madcatse/ZXSpectrumPlus3_Midi_output/zx_midi_case_PLA/output/fit_check/README.md

Необязательные примерочные срезы корпуса, не полноценные половинки.
Печатать по 1 шт. fit_bottom.stl и fit_top.stl в сохранённой ориентации, PLA,
слой 0,16–0,20 мм, сопло 0,4 мм. При необходимости добавить кайму 3 мм.
Крепёж: 2 винта M2 × 20 и 2 гайки M2, как у полного корпуса.
Проверяют отверстия платы, карманы гаек и стойки рядом с компонентами.
Окна разъёмов и опоры на концах платы в эти короткие образцы не входят.
