madcatse/ZXSpectrumPlus3_Midi_output/zx_midi_case_PLA/output/preview_board_in_base.png

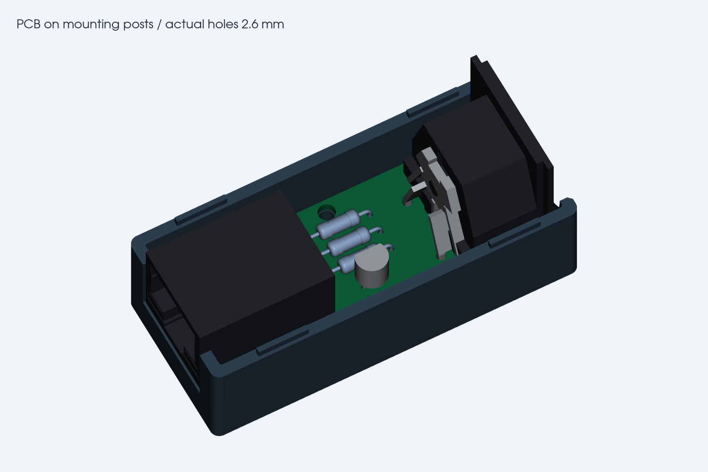
zx_midi_case_PLA/output/preview_board_in_base.png
