madcatse/ZXSpectrumPlus3_Midi_output/zx_midi_case_PLA/output/preview_exploded.png

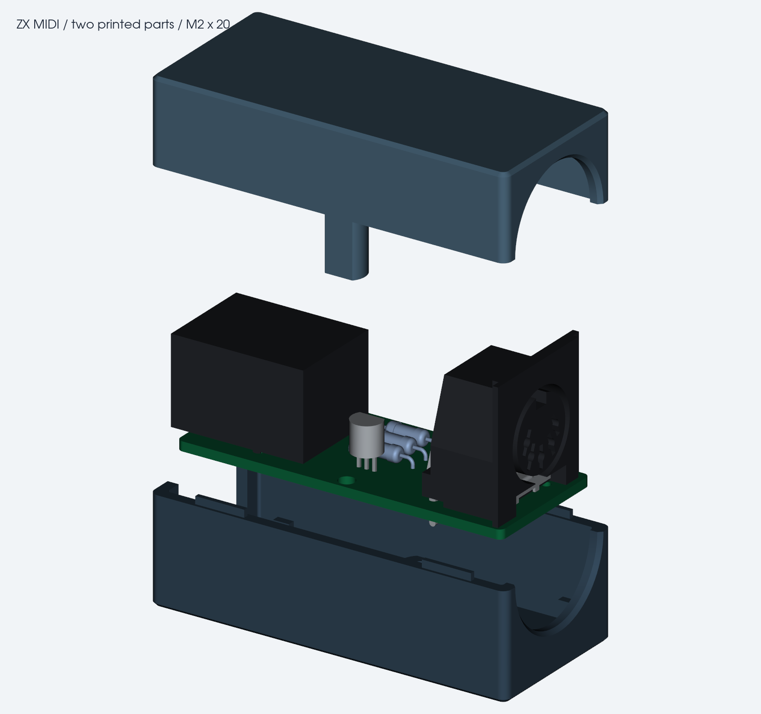
zx_midi_case_PLA/output/preview_exploded.png
