madcatse/ZXSpectrumPlus3_Midi_output/zx_midi_case_PLA/output/preview_rj45.png

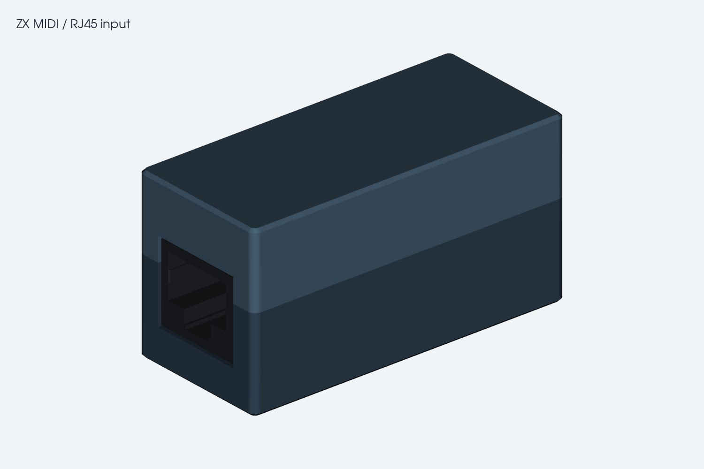
zx_midi_case_PLA/output/preview_rj45.png
