madcatse/ZXSpectrumPlus3_Midi_output/zx_midi_case_PLA/output/preview_top_inside.png

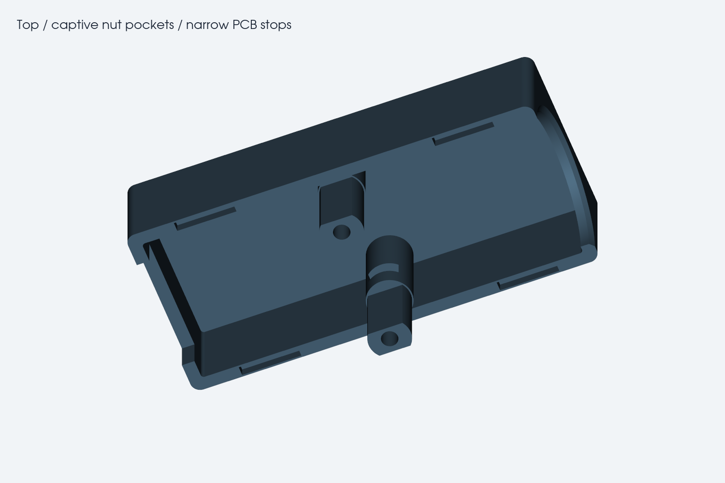
zx_midi_case_PLA/output/preview_top_inside.png
