madcatse/ZXSpectrumPlus3_Midi_output/zx_midi_case_PLA/output/assembly_with_board.step

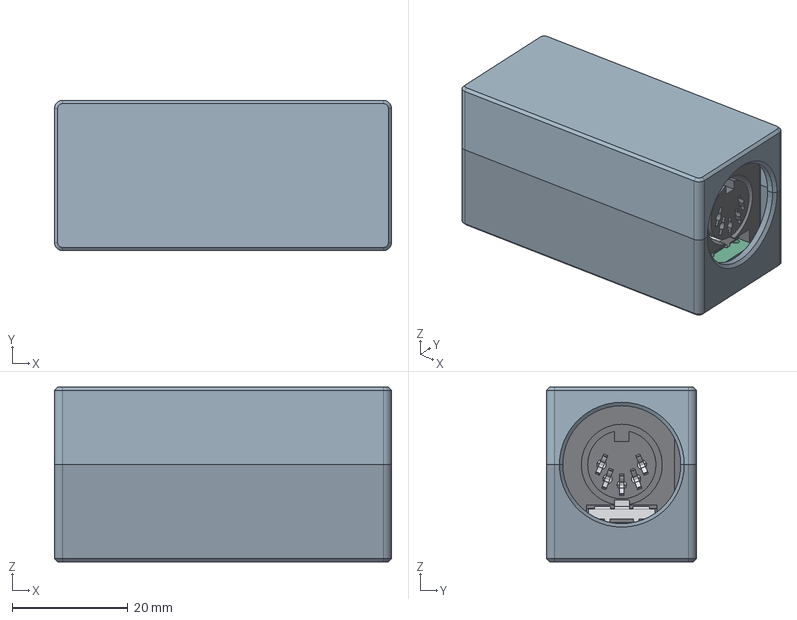
[picture p6: CAD file, 2026-10-11]
zx_midi_case_PLA/output/assembly_with_board.step
58.3 x 26.0 x 30.2 mm
Bottom
Top
PCB_reference_00
PCB_reference_01
PCB_reference_02
PCB_reference_03
PCB_reference_04
PCB_reference_05
PCB_reference_06
PCB_reference_07
PCB_reference_08
PCB_reference_09
PCB_reference_10
PCB_reference_11
PCB_reference_12
PCB_reference_13
PCB_reference_14
PCB_reference_15
PCB_reference_16
PCB_reference_17
PCB_reference_18
PCB_reference_19
PCB_reference_20
PCB_reference_21
Hardware_envelope_0
Hardware_envelope_1
Hardware_envelope_2
Hardware_envelope_3
