madcatse/ZXSpectrumPlus3_Midi_output/zx_midi_case_PLA/output/case_bottom.step

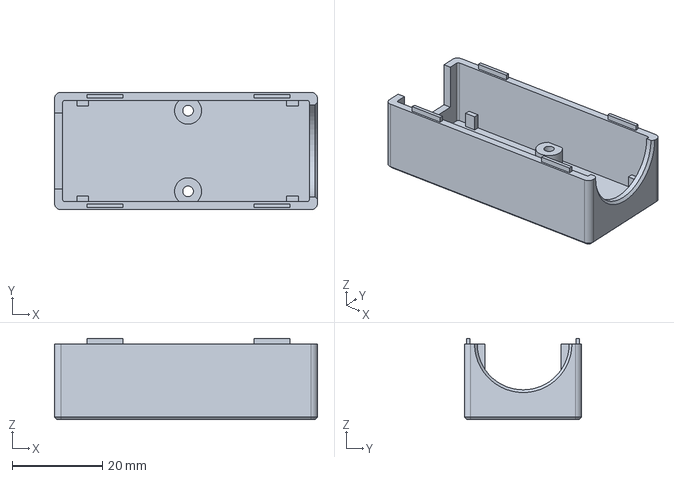
[picture p7: CAD file, 2026-10-11]
zx_midi_case_PLA/output/case_bottom.step
58.3 x 26.0 x 18.0 mm
