madcatse/ZXSpectrumPlus3_Midi_output/zx_midi_case_PLA/output/fit_check/fit_bottom.stl

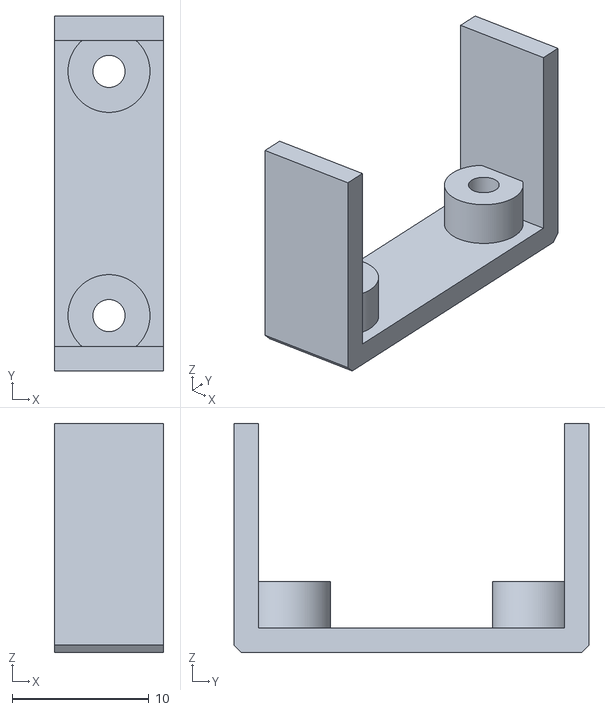
[picture p8: CAD file, 2026-10-11]
zx_midi_case_PLA/output/fit_check/fit_bottom.stl
8.00 x 26.0 x 16.8
