madcatse/ZXSpectrumPlus3_Midi_output/zxmidi.step

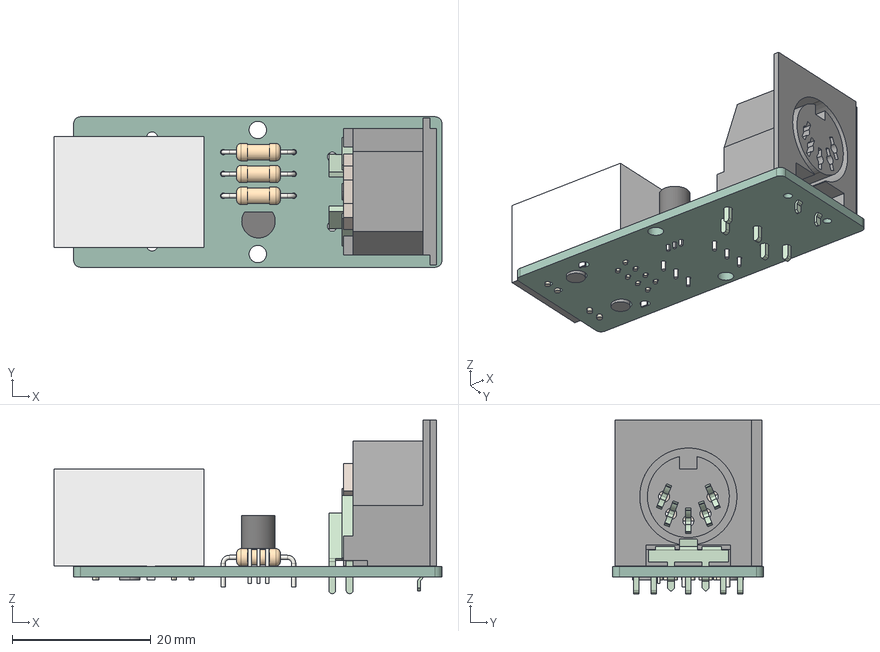
[picture p9: CAD file, 2026-10-11]
zxmidi.step
55.9 x 21.7 x 25.0 mm
DIN5_PCB_DELTRON_BODY
DIN5_PCB_DELTRON_PIN2
DIN5_PCB_DELTRON_PIN5
DIN5_PCB_DELTRON_PIN3
DIN5_PCB_DELTRON_PIN4
DIN5_PCB_DELTRON_PIN1
DIN5_PCB_DELTRON_FIX
DIN5_PCB_DELTRON_SHIELD
R_Axial_DIN0207_L63mm_D25mm_P1016mm_Horizontal x 3
TO-92_Inline_Narrow
contact x 8
zxm66B_PCB
