madcatse/ZXSpectrumPlus3_Midi_output/zx_midi_case_PLA/output/case_only.step

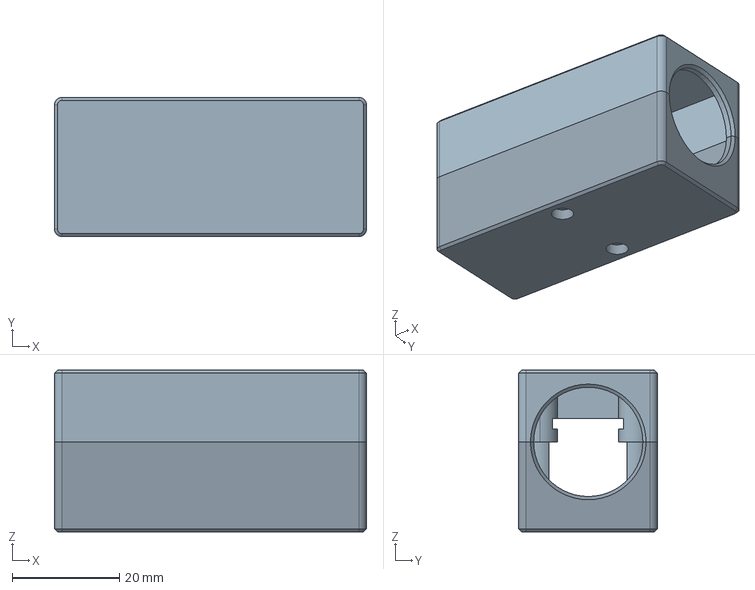
[picture p10: CAD file, 2026-10-11]
zx_midi_case_PLA/output/case_only.step
58.3 x 26.0 x 30.2 mm
Bottom
Top
