madcatse/ZXSpectrumPlus3_Midi_output/zx_midi_case_PLA/output/fit_check/fit_top.stl

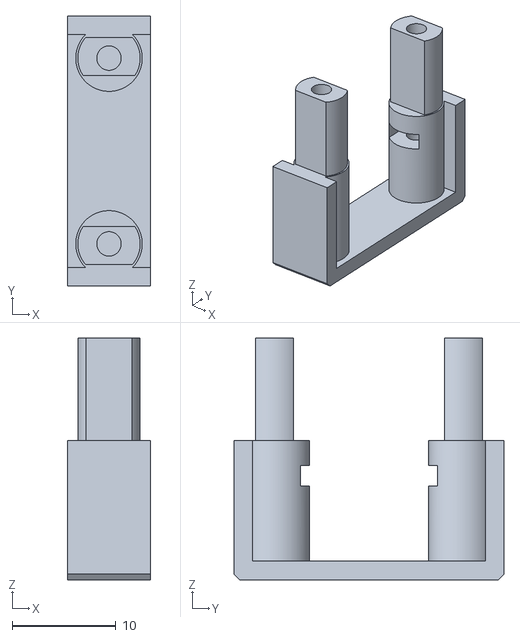
[picture p11: CAD file, 2026-10-11]
zx_midi_case_PLA/output/fit_check/fit_top.stl
8.00 x 26.0 x 23.3
