madcatse/ZXSpectrumPlus3_Midi_output/zx_midi_case_PLA/output/case_top.step

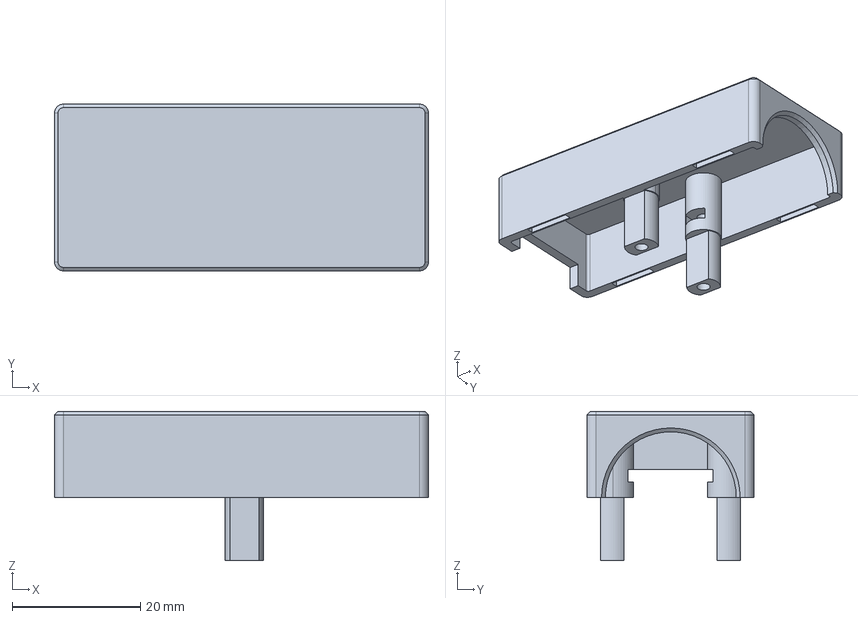
[picture p12: CAD file, 2026-10-11]
zx_midi_case_PLA/output/case_top.step
58.3 x 26.0 x 23.3 mm
