madcatse/ZXSpectrumPlus3_Midi_output/(list of files, cad)

Other CAD files:
zx_midi_case_PLA/output/case_bottom.stl
zx_midi_case_PLA/output/case_top.stl
