madcatse/ZXSpectrumPlus3_Midi_output/zxmidi.kicad_pcb

## KiCad design zxmidi.kicad_pcb (2026-10-11)

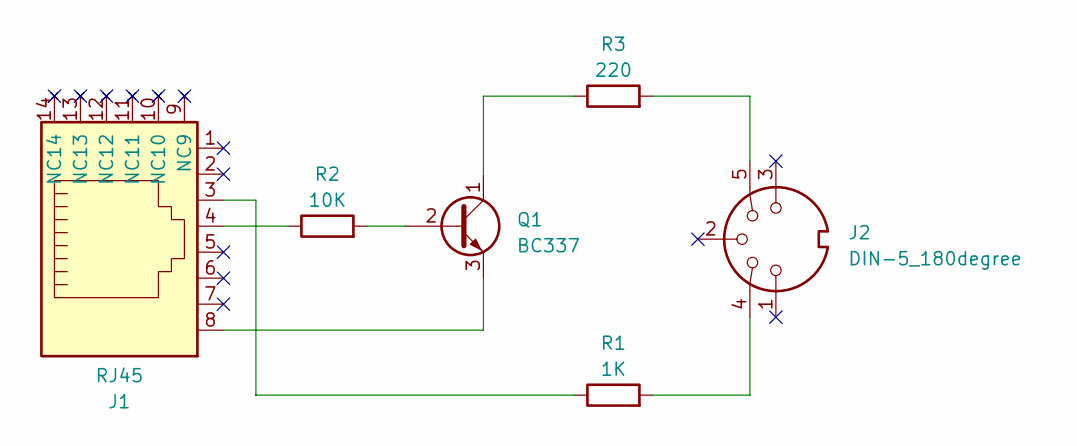
[picture p13: schematic zxmidi.kicad_sch]

Parts:
J1: RJ45; RJ45_Amphenol_54602-x08_Horizontal
J2: DIN-5_180degree; din-5
Q1: BC337; TO-92_Inline
R1: 1K; R_Axial_DIN0207_L6.3mm_D2.5mm_P10.16mm_Horizontal
R2: 10K; R_Axial_DIN0207_L6.3mm_D2.5mm_P10.16mm_Horizontal
R3: 220; R_Axial_DIN0207_L6.3mm_D2.5mm_P10.16mm_Horizontal

Connections:
unnamed: J1.3, R1.1
unnamed: J1.4, R2.1
unnamed: J2.4, R1.2
unnamed: J2.5, R3.2
unnamed: Q1.2 (B), R2.2
unnamed: Q1.1 (C), R3.1
unnamed: J1.8, Q1.3 (E)

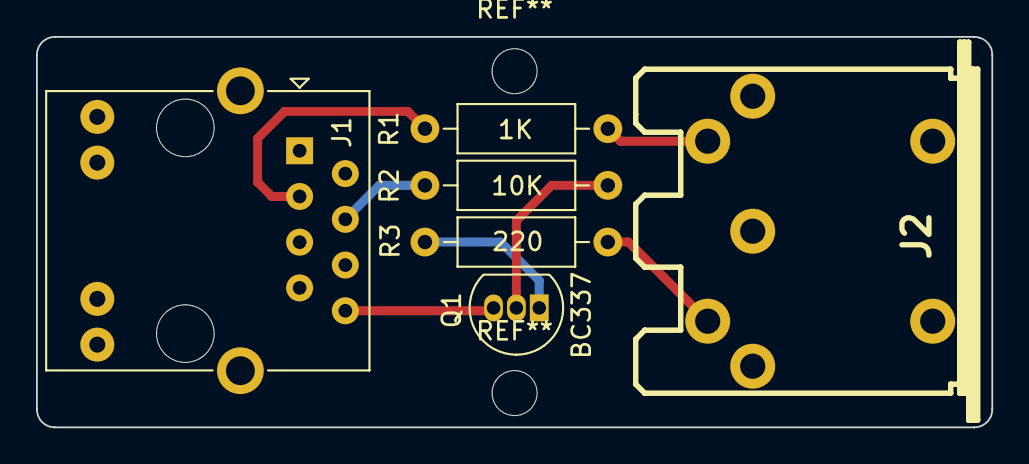
[picture p14: board zxmidi.kicad_pcb from above]

Board: 2 copper layers, 53.1 x 21.7 mm, 6 parts (0 on the bottom side), 7 nets.
