madcatse/ZXSpectrumPlus3_Midi_output/zx_midi_case_PLA/output/PRINT_AND_ASSEMBLY_RU.md

# ZX MIDI — корпус для PLA

Габариты собранного корпуса: **58,301 × 25,992 × 30,200 мм**. Две печатные
детали: нижняя ванночка и верхняя крышка. Толщина стенок, дна и крыши — 1,8 мм.
Разъёмы находятся на противоположных торцах; головки винтов утоплены снизу.

## Файлы

- `case_bottom.stl` — нижняя половинка, 1 шт.
- `case_top.stl` — верхняя половинка, 1 шт.
- `case_only.step` — обе половинки в собранном положении для CAD.
- `assembly_with_board.step` — корпус, плата и упрощённые габаритные модели крепежа.
- `case_bottom.step`, `case_top.step` — отдельные детали в координатах исходной платы.
- `preview_print_orientation.png` — правильное положение на столе.
- `validation.json` — результаты геометрической проверки.

Все размеры — в миллиметрах. STEP деталей сохранён в исходных координатах платы.
STL уже повёрнуты для печати и стоят на Z=0. При импорте STL выбирайте
**отдельные объекты**, а не детали одной сборки; печатайте в масштабе 100%.

## Крепёж

- 2 винта **M2 × 20 мм с цилиндрической головкой**. Длина 20 мм считается
  от нижней поверхности головки. Подходящая головка: диаметр до 4 мм,
  высота до 2 мм; например, винт под внутренний шестигранник.
- 2 обычные шестигранные гайки **M2**, размер под ключ 4 мм, толщина 1,6 мм.

Потайные винты, саморезы, термовставки и клей для этой версии не требуются.
Гайки удерживаются от проворачивания в карманах крышки.

## Посадка платы

Центры двух отверстий взяты из нового `zxmidi.step` без смещения:

| Отверстие | X исходного STEP, мм | Y исходного STEP, мм |
|---|---:|---:|
| 1 | 66,374899 | −53,873400 |
| 2 | 66,374899 | −35,991800 |

Межосевое расстояние — **17,8816 мм**. В исходном STEP отверстия имеют диаметр
2,5 мм, но для проверки и сборочной модели использован сообщённый фактический
диаметр **2,6 мм**. Исходный файл не изменялся. Винты M2 свободно проходят через
плату; рассверливать её под корпус не нужно.

Нижние стойки поддерживают плату вокруг отверстий. Четыре дополнительные
опоры под краями разгружают плату при подключении кабелей. Продлённые стойки
крышки ограничивают подъём платы. Их плоские внутренние стороны обходят
резистор и транзистор.

Заложены следующие зазоры:

- 0,35 мм между краями платы и боковыми стенками;
- 0,20 мм над верхней поверхностью платы в STEP толщиной 1,51 мм;
- 1,00 мм от самых длинных выводов в STEP до внутреннего дна;
- 0,60 мм над DIN-разъёмом;
- 0,25 мм на сторону в направляющих соединения половинок.

Наиболее тесное место — стойка крышки рядом с крайним резистором: по модели
зазор 0,253 мм. Перед затяжкой проверьте, что реальный резистор не упирается
в стойку. Габариты припоя и фактическое положение компонентов STEP не гарантирует.

## Печать PLA

Начальные настройки для сопла 0,4 мм:

- слой 0,16–0,20 мм;
- 4 периметра;
- 5 верхних и 5 нижних сплошных слоёв;
- заполнение 20–30%;
- внешняя плоская поверхность каждой половинки лежит на столе;
- поддержки выключены: модель рассчитана на эту ориентацию; в карманах гаек
  остаются короткие мосты шириной около 4,35 мм;
- кайма 3–5 мм нужна только при проблемах с адгезией.

Верхнюю деталь печатайте крышей вниз, длинными стойками вверх, как в STL.
Не ставьте её длинными стойками на стол. Параметры температуры и скорости
выбирайте по своему PLA и принтеру. Модель не проходила физическую пробную печать.

Если принтер сужает малые отверстия, аккуратно очистите **только печатные**
проходы винтов сверлом 2,0–2,2 мм. Номинальный диаметр этих проходов в CAD — 2,35 мм.
Уберите наплывы первого слоя у стыка и входов в карманы, не масштабируя весь корпус.

## Быстрая проверка перед полной печатью — необязательно

В папке `fit_check` лежат `fit_bottom.stl` и `fit_top.stl`. Это узкие срезы
корпуса шириной 8 мм через обе точки крепления. Они воспроизводят межосевое
расстояние, карманы гаек, стойки и зазоры рядом с компонентами.

Распечатайте по одной детали и примеряйте с платой, теми же винтами и гайками.
Они позволяют проверить посадку до печати всего корпуса. Плату придерживайте
рукой: короткий образец не поддерживает её концы. Эти образцы не заменяют
полноценные половинки корпуса и не проверяют окна разъёмов.

## Сборка

1. Очистите отверстия и направляющие. Сначала состыкуйте пустые половинки:
   они должны закрываться без сильного давления.
2. Вставьте две гайки M2 в боковые входы карманов на внутренних стойках крышки.
   Совместите отверстия гаек с каналами винтов; при необходимости используйте пинцет.
3. Уложите плату в основание компонентами вверх, совместив два отверстия
   со стойками. Проверьте, что выводы и припой не касаются дна.
4. Опустите крышку вертикально. Совместите четыре направляющих; стойки крышки
   должны пройти рядом с компонентами без нажима на них.
5. Удерживая половинки, вставьте два винта M2 × 20 снизу и наживите в гайки.
   Подтягивайте поочерёдно до смыкания стыка. Не стягивайте винтами перекошенный
   корпус и не затягивайте с усилием, способным продавить PLA или плату.
6. Проверьте подключение и извлечение обоих кабелей, в том числе нажатие
   защёлки RJ45. Окно DIN — Ø20,4 мм с расширением до Ø21,6 мм снаружи;
   лицевая поверхность разъёма утоплена примерно на 2,96 мм.

## Что проверено

Для обеих деталей проверены корректность CAD-тела, одна связная замкнутая
STL-оболочка и согласованное направление граней. Проверены отсутствие
пересечений с платой/компонентами, крепежом и второй половинкой, а также
несколько промежуточных положений при вертикальной сборке и вставке гаек.
Повторный импорт сборочного STEP подтвердил две детали корпуса.

Реальные штекеры и припой в STEP отсутствуют, поэтому их посадку и работу
защёлки RJ45 нужно проверить на первой распечатке. Это проверенный цифровой
проект, но ещё не физически испытанный корпус.

Для изменения зазоров и повторного экспорта используйте `build_case_v2.py`
в корне проекта. `build_case.py` запускает ту же актуальную версию.
