madcatse/ZXSpectrumPlus3_Midi_output/zx_midi_case_PLA/output/preview_print_orientation.png

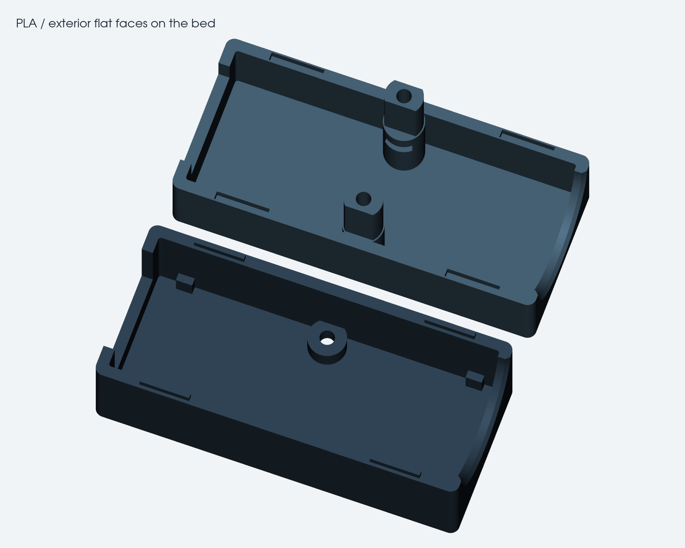
zx_midi_case_PLA/output/preview_print_orientation.png
