madcatse/ZXSpectrumPlus3_Midi_output/(commit log)

2023-09-22 3d models rework
    [zxmidi.kicad_pcb, zxmidi.step]
2025-01-02 Error fix
    [zxmidi.kicad_pcb, zxmidi.kicad_sch]
2025-01-03 Case draft
    [zxmidi.kicad_pcb, zxmidi.step]
2025-01-28 Gerbers fixed
    [zxmidi-B_Cu.gbr, zxmidi-B_Mask.gbr, zxmidi-B_Silkscreen.gbr, zxmidi-Edge_Cuts.gbr, zxmidi-F_Cu.gbr, zxmidi-F_Mask.gbr, zxmidi-F_Silkscreen.gbr, zxmidi-NPTH-drl_map.gbr]
2025-08-28 Update for Kicad 9.0.3
    [zxmidi.kicad_pcb, zxmidi.kicad_sch]
2026-10-11 Case Upload
    [assembly_with_board.step, case_bottom.step, case_bottom.stl, case_only.step, case_top.step, case_top.stl, fit_bottom.stl, fit_top.stl]
